crawler-john/ECU-R-RS/document/ECU_RS通讯协议0.6.docx

# ECU_RS通讯协议

文档版本号： | 0.6 | 文档编号：
文档密级： | 保密 | 归属部门/项目： | 研发部
产品名： | ECU_RS通讯协议 | 子系统名：
编写人： | | 编写日期： | 2017-05-26


昱能光伏科技集成有限公司 版权所有

内部资料 注意保密

修订记录：

修订版本号 | 修订人 | 修订日期 | 修订描述
V0.1 | 周豪军 | 2017-05-26 | 创建
V0.2 | 董笙烽 | 2017-06-05 | 固定ASK报文头部Command_Id位置为第10和第11字节，将原来的12个字节的ECU_ID移至Command_Id后面。
V0.3 | 董笙烽 | 2017-06-06 | 增加06设置IO初始状态指令
V0.4 | 董笙烽 | 2017-06-26 | 修改02系统信息请求，增加频繁重启标志。 修改06命令为关闭或者开启RSD2的rapid shut down功能
V0.5 | 董笙烽 | 2017-06-27 | 修改02系统信息请求，将频繁重启标志更改为逆变器快速关闭功能是否打开，并增加“当前一天关机次数”字段。
V0.6 | 董笙烽 | 2017-06-30 | 变更获取基本信息返回参数 变更系统信息请求返回参数

# 1 APP→ECU_RS获取基本信息的请求

Ask：

Head：

字段名 | 字节数 | 类型 | 描述
MSG_Tag | 3 | String | 消息标签，固定为字符串“APS”
MSG_Version | 2 | Number String | 1.1版本即为11，以此类推
Total_Length | 4 | Number String | 消息总长度（含消息头及消息体）。 如包的实际长度为0164个字节，用字符串“164”表示。如果不足，填充字符0
Command_Id | 2 | Number String | 获取基本信息01。
UID_MSG_End | 3 | String | 固定标志位“END”

Answer：
Head：

字段名 | 字节数 | 类型 | 描述
MSG_Tag | 3 | String | 消息标签，固定为字符串“APS”
MSG_Version | 2 | Number String | 1.1版本即为11，以此类推
Total_Length | 4 | Number String | 消息总长度（含消息头及消息体）。 如包的实际长度为0164个字节，用字符串“164”表示。如果不足，填充字符0
Command_Id | 2 | Number String | 获取UID的信息01

Body：

字段名 | 字节数 | 类型 | 描述
ECU_NO | 12 | Number String | ECU的ID号，如“101123456880”
TYPE | 3 | Number String | Ecu_Rs版本号初定为101，和逆变器区分开
SIGNAL_LEVEL | 3 | Number String | 信号强度（0-255）
SIGNAL_CHANNEL | 2 | Number String | 信号通道（0-99）
Equipment_Status | 1 | String | 当前设备连接的RSD类型 0：监控设备 1：开关设备 2：两者混搭
Length | 3 | String | 软件版本号的长度，不够补0
Version | Length | String | ECU_RS的软件版本号
UID_MSG_End | 3 | String | 固定标志位“END”

# 2 APP→ ECU_RS系统信息请求

Ask:

head

字段名 | 字节数 | 类型 | 描述
MSG_Tag | 3 | String | 消息标签，固定为字符串“APS”
MSG_Version | 2 | Number String | 1.1版本即为11，以此类推
Total_Length | 4 | Number String | 消息总长度（含消息头及消息体）。 如包的实际长度为0164个字节，用字符串“164”表示。如果不足，填充字符0
Command_Id | 2 | Number String | 系统信息请求02
Ecu_NO | 12 | Number String | ECU_RS需要检测改id是否匹配
UID_MSG_End | 3 | String | 固定标志位“END”

Answer:

head

字段名 | 字节数 | 类型 | 描述
MSG_Tag | 3 | String | 消息标签，固定为字符串“APS”
MSG_Version | 2 | Number String | 1.1版本即为11，以此类推
Total_Length | 4 | Number String | 消息总长度（含消息头及消息体）。 如包的实际长度为0164个字节，用字符串“164”表示。如果不足，填充字符0
Command_Id | 2 | Number String | 系统信息请求02
Answer | 2 | Number String | 00:ECU匹配、01:ECU不匹配（无body信息）

Body：

字段名 | 字节数 | 类型 | 描述
Valid_Num | 2 | String | 当前连接的RSD2数量 以0xD8 0xA7 俩个字节为列；可表示为DBA7的16进制数，即为56231，上限65535
Inverter_body | 设备状态适应 | String | 见下表，不同的设备存在不同的Inverter_body，通过Equipment_Status的不同，选择不同的Inverter_body。
Next_Turn | 不限 | String | 继续下次UID操作，直到结束
UID_MSG_End | 3 | String | 固定标志位“END”

Inverter_body ：

监控设备：

字段名 | 字节数 | 类型 | 描述
UID_ID | 6 | Number String | 0x40表示40，0x38表示38，只需6字节
Equipment_Status | 1 | String | 当前设备状态 0：监控设备
Status | 1 | String | 第1位：表示Mos_Status ： 1 :开、0: 关 第2位：表示rapid shut down功能是否打开：1：开、0：关 第3位：PV1欠压保护标志 1：欠压 0：非欠压 第4位：PV2欠压保护标志 1：欠压 0：非欠压
Heart_Rate | 2 | String | 以0x30 0x39 俩个字节为列；可表示为3039的16进制数，即为12345，上限65535
Off_Times | 2 | String | 以0xD8 0xA7 俩个字节为列；可表示为DBA7的16进制数，即为56231，上限65535
Shutdown_Num | 1 | String | 当前一天关机次数（系统连续一小时通讯不上表示进入晚上，清空该RSD2关机次数）
PV1_voltage | 1 | String | PV1输入电压(精度1V)
PV2_voltage | 1 | String | PV2输入电压(精度1V)
PV_electricity | 1 | String | 输入电流(精度0.1A)
PV1_power | 2 | String | PV1输入功率(精度1W)
PV2_power | 2 | String | PV2输入功率(精度1W)

开关设备：

字段名 | 字节数 | 类型 | 描述
UID_ID | 6 | Number String | 0x40表示40，0x38表示38，只需6字节
Equipment_Status | 1 | String | 当前设备状态 1：开关设备
Status | 1 | String | 第1位：表示Mos_Status ： 1 :开、0: 关 第2位：表示rapid shut down功能是否打开：1：开、0：关
Heart_Rate | 2 | String | 以0x30 0x39 俩个字节为列；可表示为3039的16进制数，即为12345，上限65535
Off_Times | 2 | String | 以0xD8 0xA7 俩个字节为列；可表示为DBA7的16进制数，即为56231，上限65535
Shutdown_Num | 1 | String | 当前一天关机次数（系统连续一小时通讯不上表示进入晚上，清空该RSD2关机次数）

# 3 APP→ECU_RS设置ECU组网

Ask:

head

字段名 | 字节数 | 类型 | 描述
MSG_Tag | 3 | String | 消息标签，固定为字符串“APS”
MSG_Version | 2 | Number String | 1.1版本即为11，以此类推
Total_Length | 4 | Number String | 消息总长度（含消息头及消息体）。 如包的实际长度为0164个字节，用字符串“164”表示。如果不足，填充字符0
Command_Id | 2 | Number String | 设置ecu组网 03
Ecu_NO | 12 | Number String | ECU_RS需要检测改id是否匹配
UID_MSG_End | 3 | String | 固定标志位“END”

Body：

字段名 | 字节数 | 类型 | 描述
UID_ID | 6 | Number String | 0x40表示40，0x38表示38，只需6字节
Next_UID | 不限 | String | 继续拼接下一个uid直到结束
UID_MSG_End | 3 | String | 固定标志位“END”

Answer:

head

字段名 | 字节数 | 类型 | 描述
MSG_Tag | 3 | String | 消息标签，固定为字符串“APS”
MSG_Version | 2 | Number String | 1.1版本即为11，以此类推
Total_Length | 4 | Number String | 消息总长度（含消息头及消息体）。 如包的实际长度为0164个字节，用字符串“164”表示。如果不足，填充字符0
Command_Id | 2 | Number String | 设置ecu组网 03
Answer | 2 | Number String | 00:下发成功、01:ECU不匹配

# 4 APP→ECU_RS设置ECU信道

Ask:

head

字段名 | 字节数 | 类型 | 描述
MSG_Tag | 3 | String | 消息标签，固定为字符串“APS”
MSG_Version | 2 | Number String | 1.1版本即为11，以此类推
Total_Length | 4 | Number String | 消息总长度（含消息头及消息体）。 如包的实际长度为0164个字节，用字符串“164”表示。如果不足，填充字符0
Command_Id | 2 | Number String | 设置ecu信道 04
Ecu_NO | 12 | Number String | ECU_RS需要检测改id是否匹配
UID_MSG_End | 3 | String | 固定标志位“END”

Body：

字段名 | 字节数 | 类型 | 描述
SIGNAL_CHANNEL | 2 | Number String | 0-99
UID_MSG_End | 3 | String | 固定标志位“END”

Answer:

head

字段名 | 字节数 | 类型 | 描述
MSG_Tag | 3 | String | 消息标签，固定为字符串“APS”
MSG_Version | 2 | Number String | 1.1版本即为11，以此类推
Total_Length | 4 | Number String | 消息总长度（含消息头及消息体）。 如包的实际长度为0164个字节，用字符串“164”表示。如果不足，填充字符0
Command_Id | 2 | Number String | 设置ecu信道 04
Answer | 2 | Number String | 00:下发成功、01:ECU不匹配（无body消息）

Body：

字段名 | 字节数 | 类型 | 描述
SIGNAL_CHANNEL | 2 | Number String | 0-99 当前通道0-99之间
SIGNAL_LEVEL | 3 | Number String | 0-255 当前信号强度0-255之间
UID_MSG_End | 3 | String | 固定标志位“END”

# 5 APP→ECU_RS设置ECUWIFI密码

Ask:

head

字段名 | 字节数 | 类型 | 描述
MSG_Tag | 3 | String | 消息标签，固定为字符串“APS”
MSG_Version | 2 | Number String | 1.1版本即为11，以此类推
Total_Length | 4 | Number String | 消息总长度（含消息头及消息体）。 如包的实际长度为0164个字节，用字符串“164”表示。如果不足，填充字符0
Command_Id | 2 | Number String | 设置ecuwifi密码 05
Ecu_NO | 12 | Number String | ECU_RS需要检测改id是否匹配
UID_MSG_End | 3 | String | 固定标志位“END”

Body：

字段名 | 字节数 | 类型 | 描述
OLD_LENGTH | 2 | Number String | 老密码长度
OLDPASSWORD | OLD_LENGTH | String | 0-99
NEW_LENGTH | 2 | Number String | 新密码长度
NEWPASSWORD | NEW_LENGTH | String | 0-99
UID_MSG_End | 3 | String | 固定标志位“END”

Answer:

head

字段名 | 字节数 | 类型 | 描述
MSG_Tag | 3 | String | 消息标签，固定为字符串“APS”
MSG_Version | 2 | Number String | 1.1版本即为11，以此类推
Total_Length | 4 | Number String | 消息总长度（含消息头及消息体）。 如包的实际长度为0164个字节，用字符串“164”表示。如果不足，填充字符0
Command_Id | 2 | Number String | 设置ecuwifi密码 05
Answer | 2 | Number String | 00:下发成功将会重启模块、01:ECU不匹配、02老密码不匹配

# 6 APP→ECU_RS关闭或者开启RSD2的rapid shut down功能

Ask:

head

字段名 | 字节数 | 类型 | 描述
MSG_Tag | 3 | String | 消息标签，固定为字符串“APS”
MSG_Version | 2 | Number String | 1.1版本即为11，以此类推
Total_Length | 4 | Number String | 消息总长度（含消息头及消息体）。 如包的实际长度为0164个字节，用字符串“164”表示。如果不足，填充字符0
Command_Id | 2 | Number String | 关闭或者开启RSD2的rapid shut down功能06
Ecu_NO | 12 | Number String | ECU_RS需要检测改id是否匹配
IO_Init_Status | 1 | String | 需要设置的优化器IO初始状态 0：低电平（关闭心跳功能）1：高电平（打开心跳功能）
UID_MSG_End | 3 | String | 固定标志位“END”

Answer:

head

字段名 | 字节数 | 类型 | 描述
MSG_Tag | 3 | String | 消息标签，固定为字符串“APS”
MSG_Version | 2 | Number String | 1.1版本即为11，以此类推
Total_Length | 4 | Number String | 消息总长度（含消息头及消息体）。 如包的实际长度为0164个字节，用字符串“164”表示。如果不足，填充字符0
Command_Id | 2 | Number String | 关闭或者开启RSD2的rapid shut down功能06
Answer | 2 | Number String | 00: 下发成功、01:ECU不匹配
