crawler-john/ECU-R-RS/document/ECU-RS-BOM-REV1.0-20170621.XLS

物料清单资料查询
母件编码 19608710000 |  |  |  |  |  | 母件名称 ECU-RS-REV1.0 PCBA |  |  |  |  |  | 规格型号
版本说明 REV1.0 |  |  |  |  |  | Article No.
描述
备注 2017-6-21 新建
级次 | 子件编码 | 变更标示 | 子件名称 | 子件规格 | 描述 | 主计量单位名称 | 基本用量 | 位置号1 | 位置号2 | 制造商 | 工段 | 替代标识 | 是否前烧录 | 是否特殊物料 | 替代标志 | 备注 | 单位参考成本
+1 | 12110000000 |  | 四角按键 | KFC＿A36＿08A | SMD | Pcs | 1.0000 | BP2 |  | 泰安达电子 | SMT
+1 | 10011052100 |  | 陶瓷电容 | CC0603KRX5R6BB105 | 1uF∕10V∕10%∕0603 | Pcs | 3.0000 | C1/C19/C20 |  | YAGEO | SMT
+1 | 10091042100 |  | 陶瓷电容 | CC0603KRX7R7BB104 | 100nF/16V/10%/0603 | Pcs | 11.0000 | C2/C3/C4/C5/C6/C10/C11/C18/C236/C277/C279 |  | YAGEO | SMT
+1 | 10031011100 |  | 陶瓷电容 | CC0603JRNPO9BN101 | 100pF/50V/5%/0603 | Pcs | 1.0000 | C7 |  | YAGEO | SMT
+1 | 10092252200 |  | 陶瓷电容 | CC0805KKX7R7BB225 | 2.2uF/16V/10%/0805 | Pcs | 2.0000 | C8/C9 |  | YAGEO | SMT
+1 | 10031001100 |  | 陶瓷电容 | CC0603JRNPO9BN100 | 10pF/50V/5%/0603 | Pcs | 2.0000 | C16/C17 |  | YAGEO | SMT
+1 | 10004752100 |  | 陶瓷电容 | CC0603KRX5R5BB475 | 4.7uF/6.3V/10%/0603 | Pcs | 1.0000 | C21 |  | YAGEO | SMT
+1 | 10034752300 |  | 陶瓷电容 | CC1206KKX7R9BB475 | 4.7uF/50V/10%/1206 | Pcs | 1.0000 | C48 |  | YAGEO | SMT
+1 | 10031032100 |  | 陶瓷电容 | CC0603KRX7R9BB103 | 10nF/50V/10%/0603 | Pcs | 1.0000 | C53 |  | YAGEO | SMT
+1 | 14301833710 |  | 发光二极管 | EC04-0805GC/E-AV | EC04(0805)绿 | Pcs | 2.0000 | D21/D22 |  | EVER BRIGHT | SMT
+1 | 12060000000 |  | 单排插针 | 1*2.54mm间距 引脚长度11mm 40pin | DIP | Pcs | 3.0000 | JP6/JP7/J4 |  | 国产 | DIP
+1 | 12180000001 |  | IPEX接口 |  |  | Pcs | 1.0000 | J1 |  | 昭华电子 | SMT
+1 | 12080002102 |  | 电源插座 | DC-0005D |  | Pcs | 1.0000 | J2 |  | 苏州昭华电子有限公司 | DIP
+1 | 12132021005 |  | wifi模块 | USR-WIFI232-B2 |  | Pcs | 1.0000 | J13 |  | 有人 | DIP
+1 | 17120025114 |  | 看门狗芯片 | MCP1316MT-29LE/OT | SOT-23-5 | Pcs | 1.0000 | MN3 |  | Microchip | SMT
+1 | 14700040007 |  | NPN型三极管 | MMBT2222A | SOT-23 | Pcs | 1.0000 | Q3 |  | Fairchild | SMT
+1 | 11001031100 |  | 贴片电阻 | RC0603JR-0710KL | 10K,5%,0603 | Pcs | 8.0000 | R1/R2/R3/R4/R5/R13/R14/R15 |  | YAGEO | SMT
+1 | 11082520100 |  | 贴片电阻 | RC0603FR-0782K5L | 82.5K,1﹪,0603 | Pcs | 1.0000 | R7 |  | YAGEO | SMT
+1 | 11004731100 |  | 贴片电阻 | RC0603JR-0747KL | 47K,5%,0603 | Pcs | 1.0000 | R8 |  | YAGEO | SMT
+1 | 11001020100 |  | 贴片电阻 | RC0603FR-071KL | 1K,1%,0603 | Pcs | 3.0000 | R9/R23/R199 |  | YAGEO | SMT
+1 | 11001011200 |  | 贴片电阻 | RC0805JR-07100RL | 100R，5﹪，0805 | Pcs | 1.0000 | R27 |  | YAGEO | SMT
+1 | 11005120100 |  | 贴片电阻 | RC0603FR-075K1L | 5.1K,1%,0603 | Pcs | 1.0000 | R35 |  | YAGEO | SMT
+1 | 11001010100 |  | 贴片电阻 | RC0603FR-07100RL | 100R，1﹪，0603 | Pcs | 1.0000 | R36 |  | YAGEO | SMT
+1 | 11001520100 |  | 贴片电阻 | RC0603FR-071K5L | 1.5K,1%,0603 | Pcs | 2.0000 | R164/R165 |  | YAGEO | SMT
+1 | 11001030100 |  | 贴片电阻 | RC0603FR-0710KL | 10K,1%,0603 | Pcs | 1.0000 | R342 |  | YAGEO | SMT
+1 | 11004720100 |  | 贴片电阻 | RC0603FR-074K7L | 4.7K,1﹪,0603 | Pcs | 1.0000 | R351 |  | YAGEO | SMT
+1 | 11000000100 |  | 贴片电阻 | RC0603FR-070RL | 0R，1﹪，0603 | Pcs | 2.0000 | R282/R352 |  | YAGEO | SMT
+1 | 17061096237 |  | 单片机MCU芯片 | GD32F101C8T6 | LQFP48 | Pcs | 1.0000 | U1 |  | Gigadevice | SMT
+1 | 17040186141 |  | 电源芯片 | SGM2028ADJYN5G/TR | SOT-23-5 | Pcs | 1.0000 | U2 |  | SGMICRO | SMT
+1 | 12133011104 |  | 射频模块 | RFM300H-433S2 | 工作频段433MHz | Pcs | 1.0000 | U3 |  | HOPERF | SMT
+1 | 17010022114 |  | flash 芯片 | 24LC64T-I/SN | SOIC8 | Pcs | 1.0000 | U12 |  | Microchip | SMT
+1 | 19111110104 |  | 8MHz无源晶振 | XJHCCLNANF-8.000000MHz | 8MHz_±20PPM_SMD_无源晶振_昆山正耀 | Pcs | 1.0000 | Y1 |  | TAITIEN | SMT
+1 | 19508710008 |  | PCB | ECU-RS-REV1.0 |  | Pcs | 1.0000 | PCB |  | 依利安达 | SMT
合计
制单人 蔡宁 |  |  |  |  |  | 制单日期 2017-06-21 |  |  |  |  |  | 修改日期
