crawler-john/ECU-R-RS/document/ECU-RS-SCH-V1_0-20170522B.xlsx

RSD2 Revised: Monday, May 22, 2017
Revision: 1.0
Bill Of Materials June 12,2017 15:06:37 | Page1
Item | Quantity | Reference | Part | Footprint
______________________________________________
1 | 1 | BP2 | KFC_A36_08A | SW4-KFC-A36-08 | 12110000000 | 四角按键
2 | 3 | C1,C19,C20 | 1uF∕10V∕10%∕0603 | C0603 | 10011052100 | 陶瓷电容
3 | 10 | C2,C3,C4,C5,C6,C10,C11,C18,C236,C277,C279 | 100nF/16V/10%/0603 | C0603 | 10091042100 | 陶瓷电容
4 | 1 | C7 | 100pF/50V/5%/0603 | C0603 | 10031011100 | 陶瓷电容
5 | 2 | C8,C9 | 2.2uF/16V/10%/0805 | C0805 | 10092252200 | 陶瓷电容
6 | 4 | C16,C17 | 10pF/50V/5%/0603 | C0603 | 10031001100 | 陶瓷电容
7 | 1 | C21 | 4.7uF/6.3V/10%/0603 | C0603 | 10004752100 | 陶瓷电容
8 | 1 | C48 | 4.7uF/50V/10%/1206 | C1206 | 10034752300 | 陶瓷电容
9 | 1 | C53 | 10nF/50V/10%/0603 | C0603 | 10031032100 | 陶瓷电容
11 | 2 | D21,D22 | Led Green HSMG-C170 | LED_0805 | 14301833710 | 发光二极管
12 | 2 | JP6,JP7 | TSW 2PTS-DROIT_1 | SIP2_254 | 2孔 | 排针 | 1*2.54mm间距 引脚长度11mm 40pin
13 | 1 | J1 | Ipex | IPEX-3pin |  | 天线插座
14 | 1 | J2 | DC-0005D | SW-3PIN | 12080002102 | 直流插座
16 | 1 | J4 | CON2 | HD1X2_254 | 2孔 | 排针+短路帽 | 1*2.54mm间距 引脚长度11mm 40pin
18 | 1 | J13 | WIFI conned | HD2x7_2_0-WIFI |  | 有人WIFI模块
19 | 1 | MN3 | MCP1316MT-29LE/OT DNP | SOT23_5-095-280N |  | MCP1316MT-29LE/OT
21 | 1 | Q3 | 2N1069 | sot-23 |  | 三极管
22 | 8 | R1,R2,R3,R4,R5,R13,R14,R15 | 10K,5%,0603 | R0603 | 11001031100 | 贴片电阻
23 | 1 | R7 | 82.5K,1﹪,0603 | R0603 | 11082520100 | 贴片电阻
24 | 1 | R8 | 47.5K | R0603
25 | 3 | R9,R23,R199 | 1K,1%,0603 | R0603 | 11001020100 | 贴片电阻
26 | 1 | R27 | 100R，5﹪，0805 | R0805 | 11001011200 | 贴片电阻
27 | 1 | R35 | 5.1K,1%,0603 | R0603 | 11005120100 | 贴片电阻
28 | 1 | R36 | 100R，1﹪，0603 | R0603 | 11001010100 | 贴片电阻
29 | 2 | R164,R165 | 1.5K,1%,0603 | R0603 | 11001520100 | 贴片电阻
31 | 1 | R342 | 10K,1%,0603 | R0603 | 11001030100 | 贴片电阻
32 | 1 | R351 | 4.7K,1﹪,0603 | R0603 | 11004720100 | 贴片电阻
33 | 1 | R282,R352 | 0R，1﹪，0603 | R0603 | 11000000100 | 贴片电阻
35 | 1 | U1 | GD32F101C8T6 | QFP48_050-900X900 |  | GD32F101C8T6芯片
36 | 1 | U2 | SGM2028ADJYN5G/TR | sot-23-5 |  | 电源芯片
37 | 1 | U3 | RFM300H | RFM300H |  | 433模块
38 | 1 | U12 | 24LC64 | SOP8_127-620X500 | 17010022114 | flash 芯片
39 | 1 | Y1 | 8M | CRYS2_1140X480 | 19111110104 | 8MHz无源晶振
