crawler-john/ECU-R-RS/document/ECU-RS-SCH-V1_0-20170522B.pdf

### WIFI_TX

### WIFI_RST

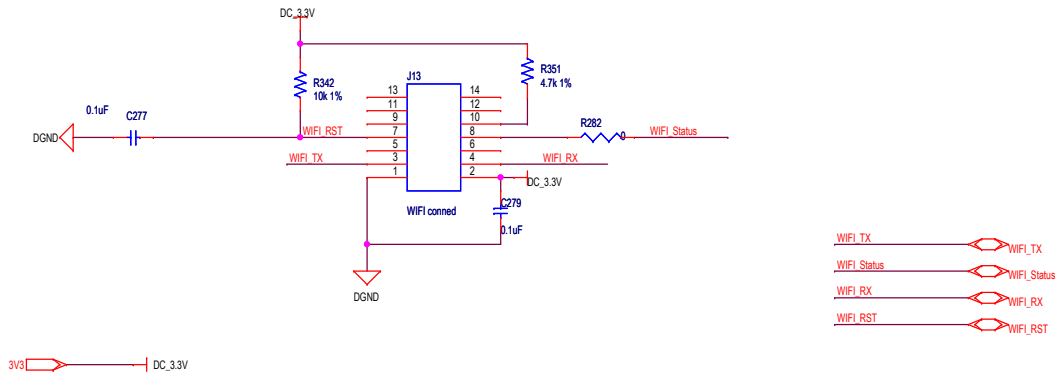
[picture p2: page 1]
WIFI_RX; WIFI_Status; WIFI_TX; WIFI_RST; DGND; WIFI conned

### EEPROM_SDA

### EEPROM_SCL

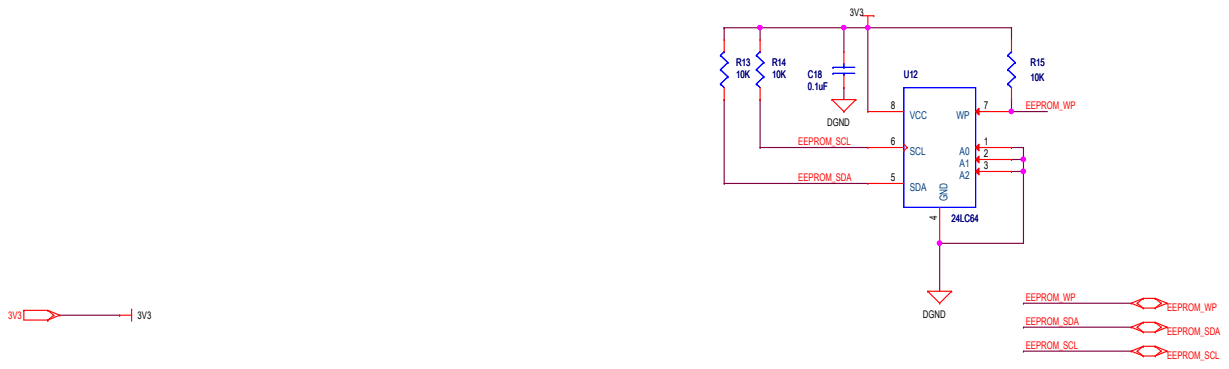
[picture p3: page 2]
EEPROM_WP; EEPROM_SDA; EEPROM_SCL; DGND; GND; SDA; SCL; VCC

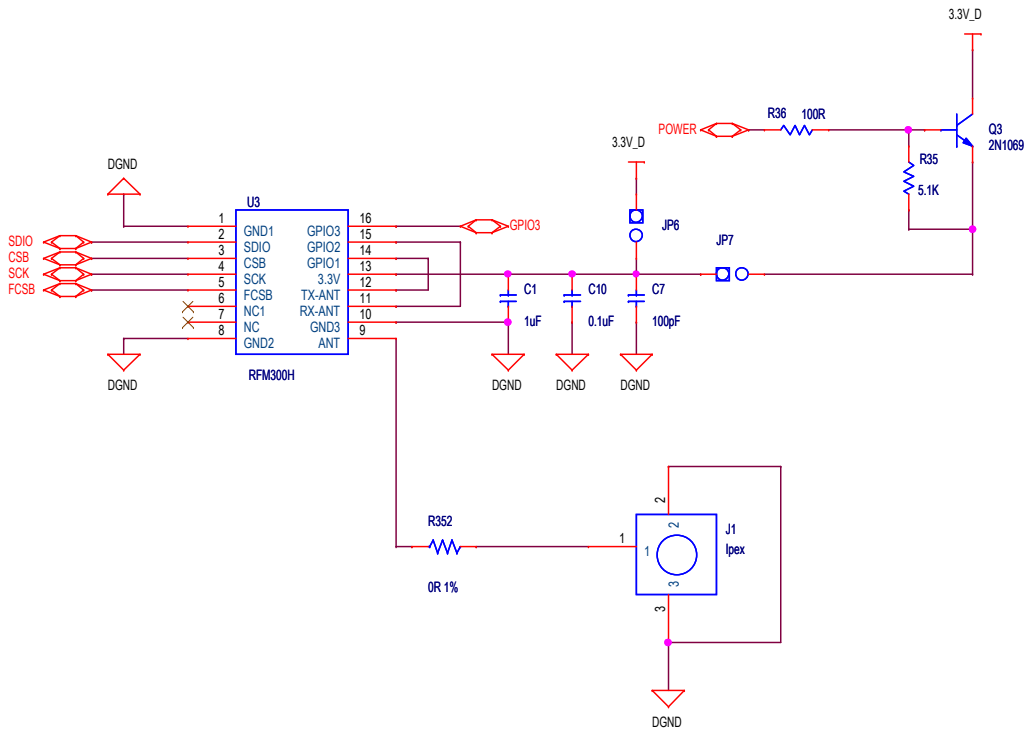
[picture p4: page 3]

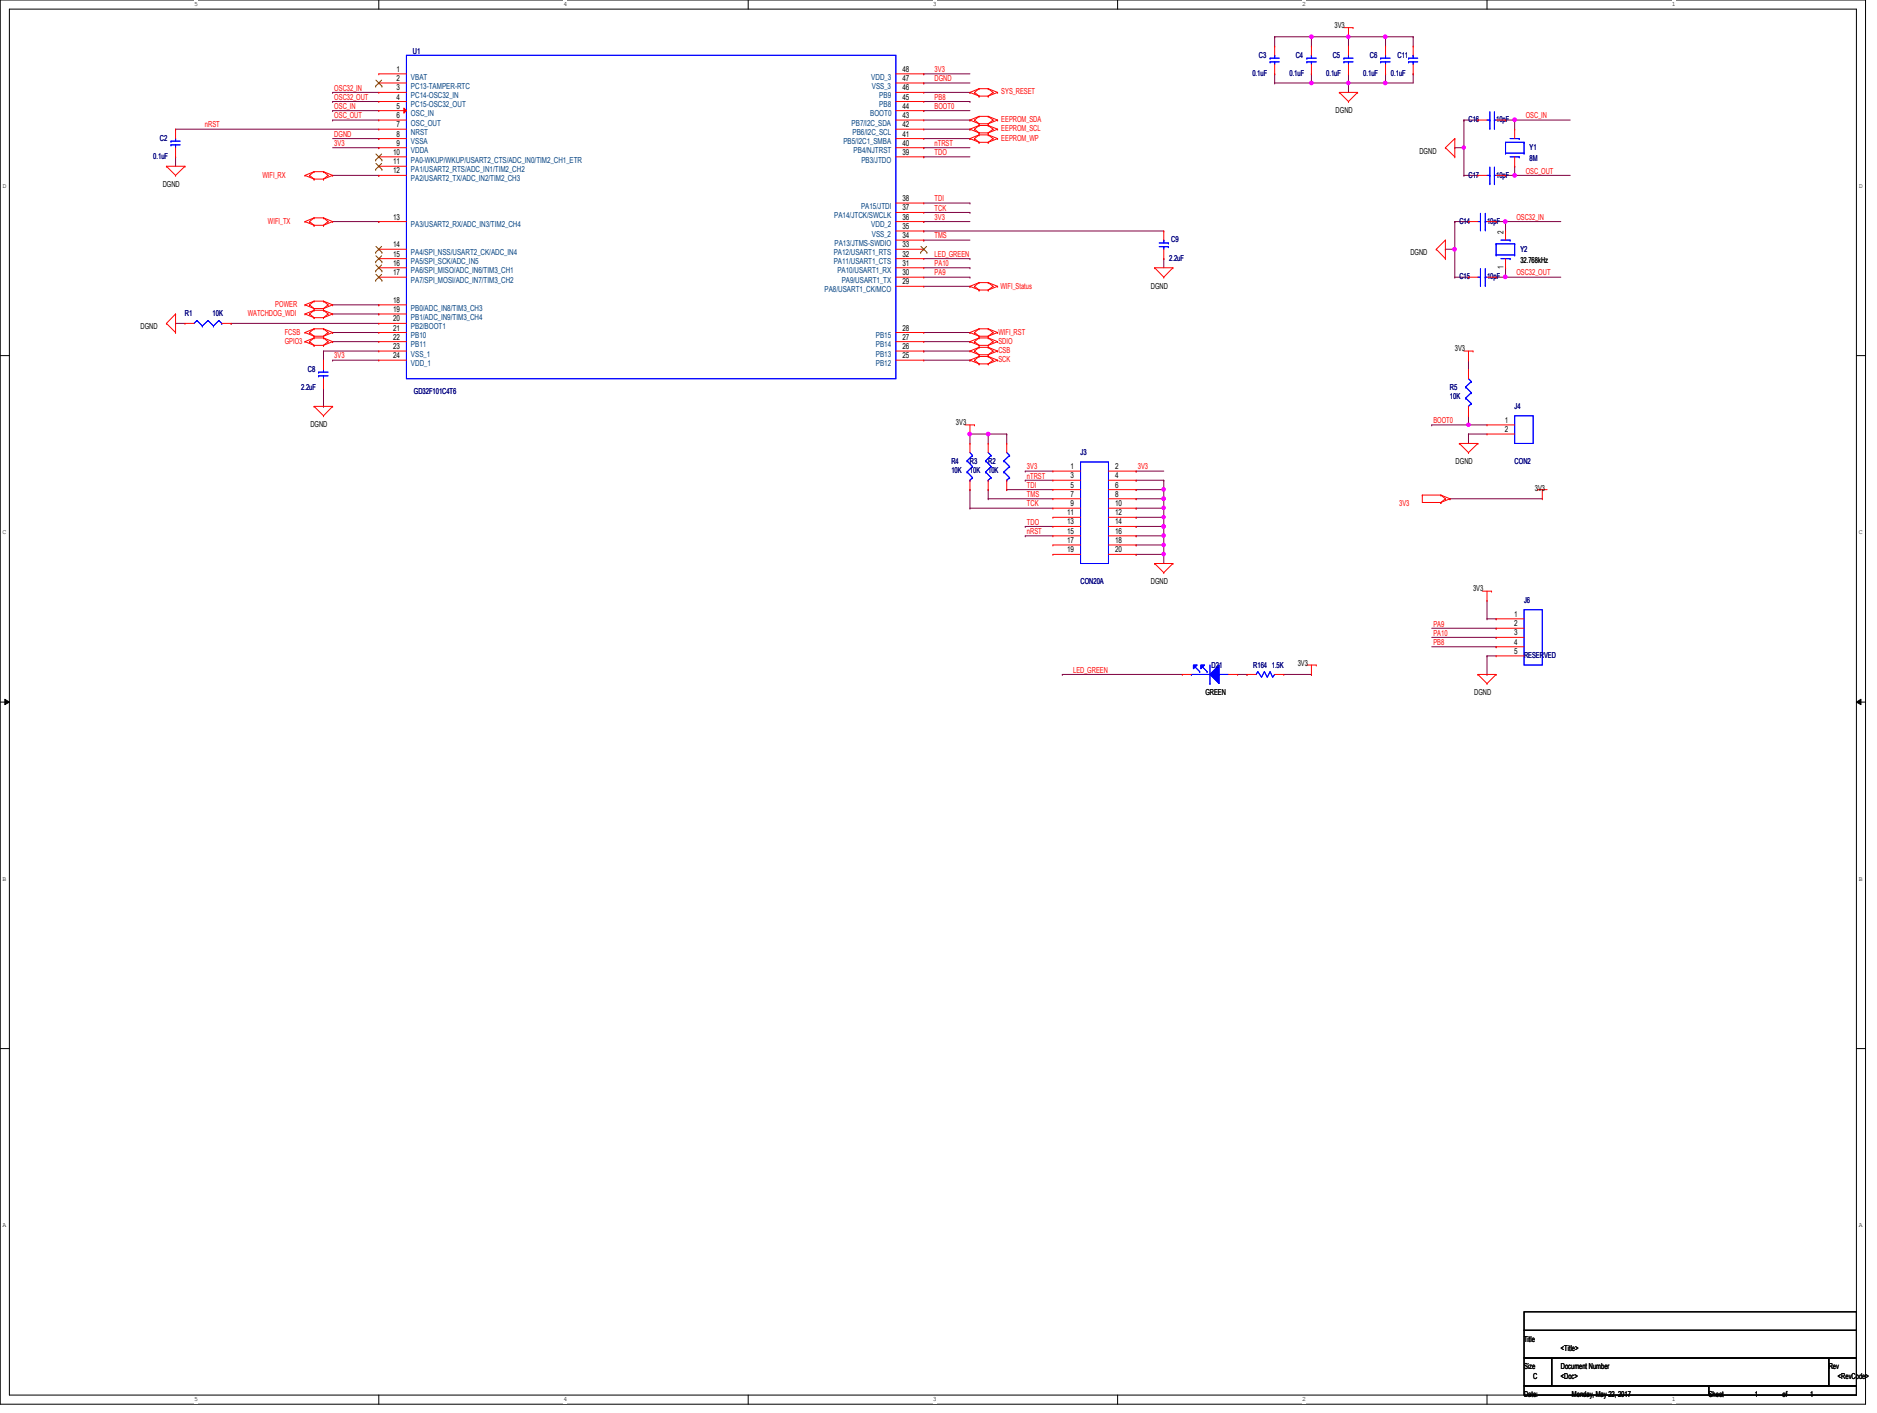
[picture p5: page 4]

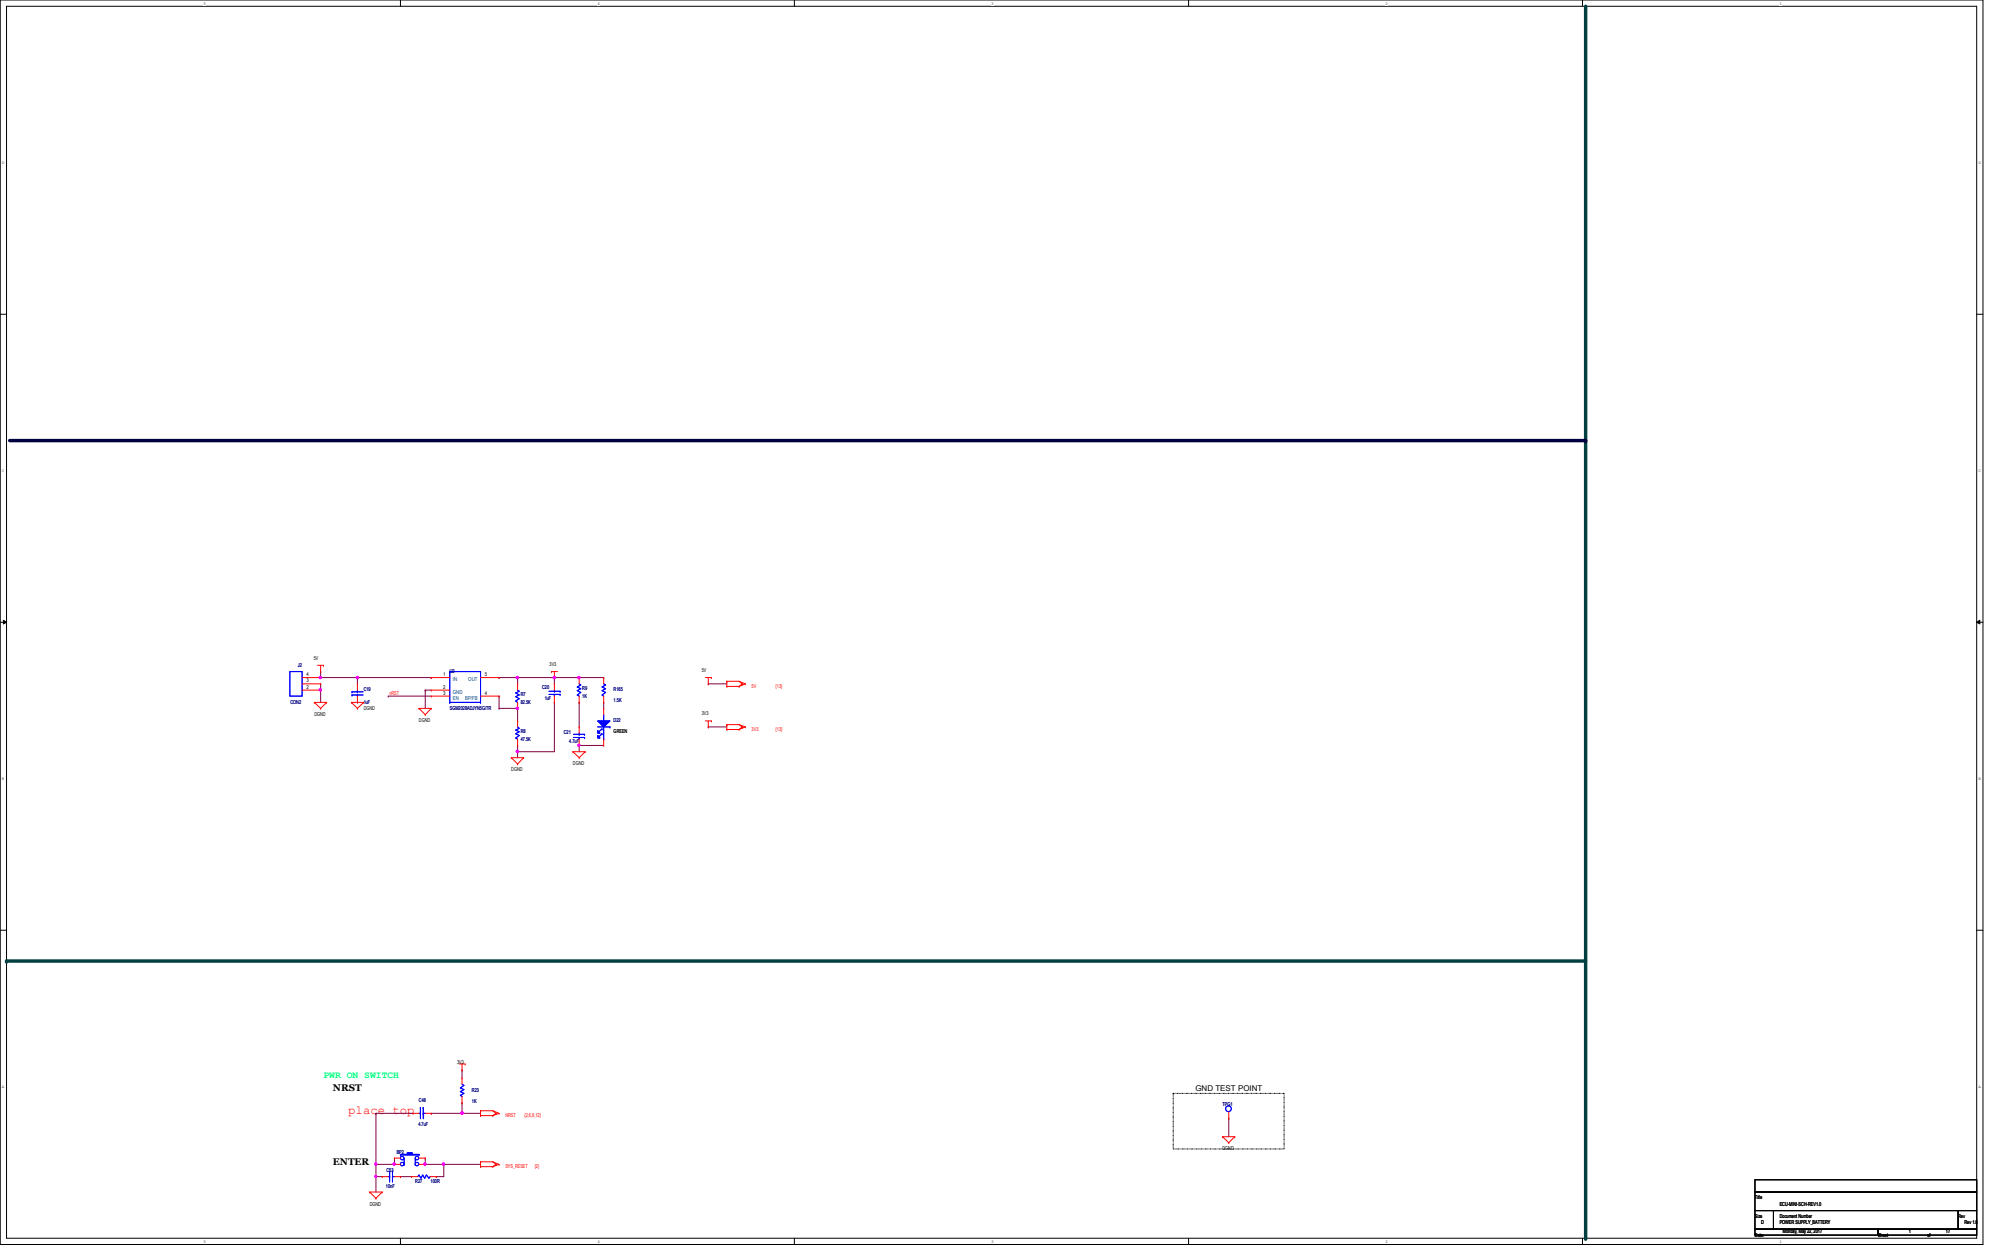
[picture p6: page 5]

# LOG FILE

# REV 1.0 First version of RSD2(2017.05.10)

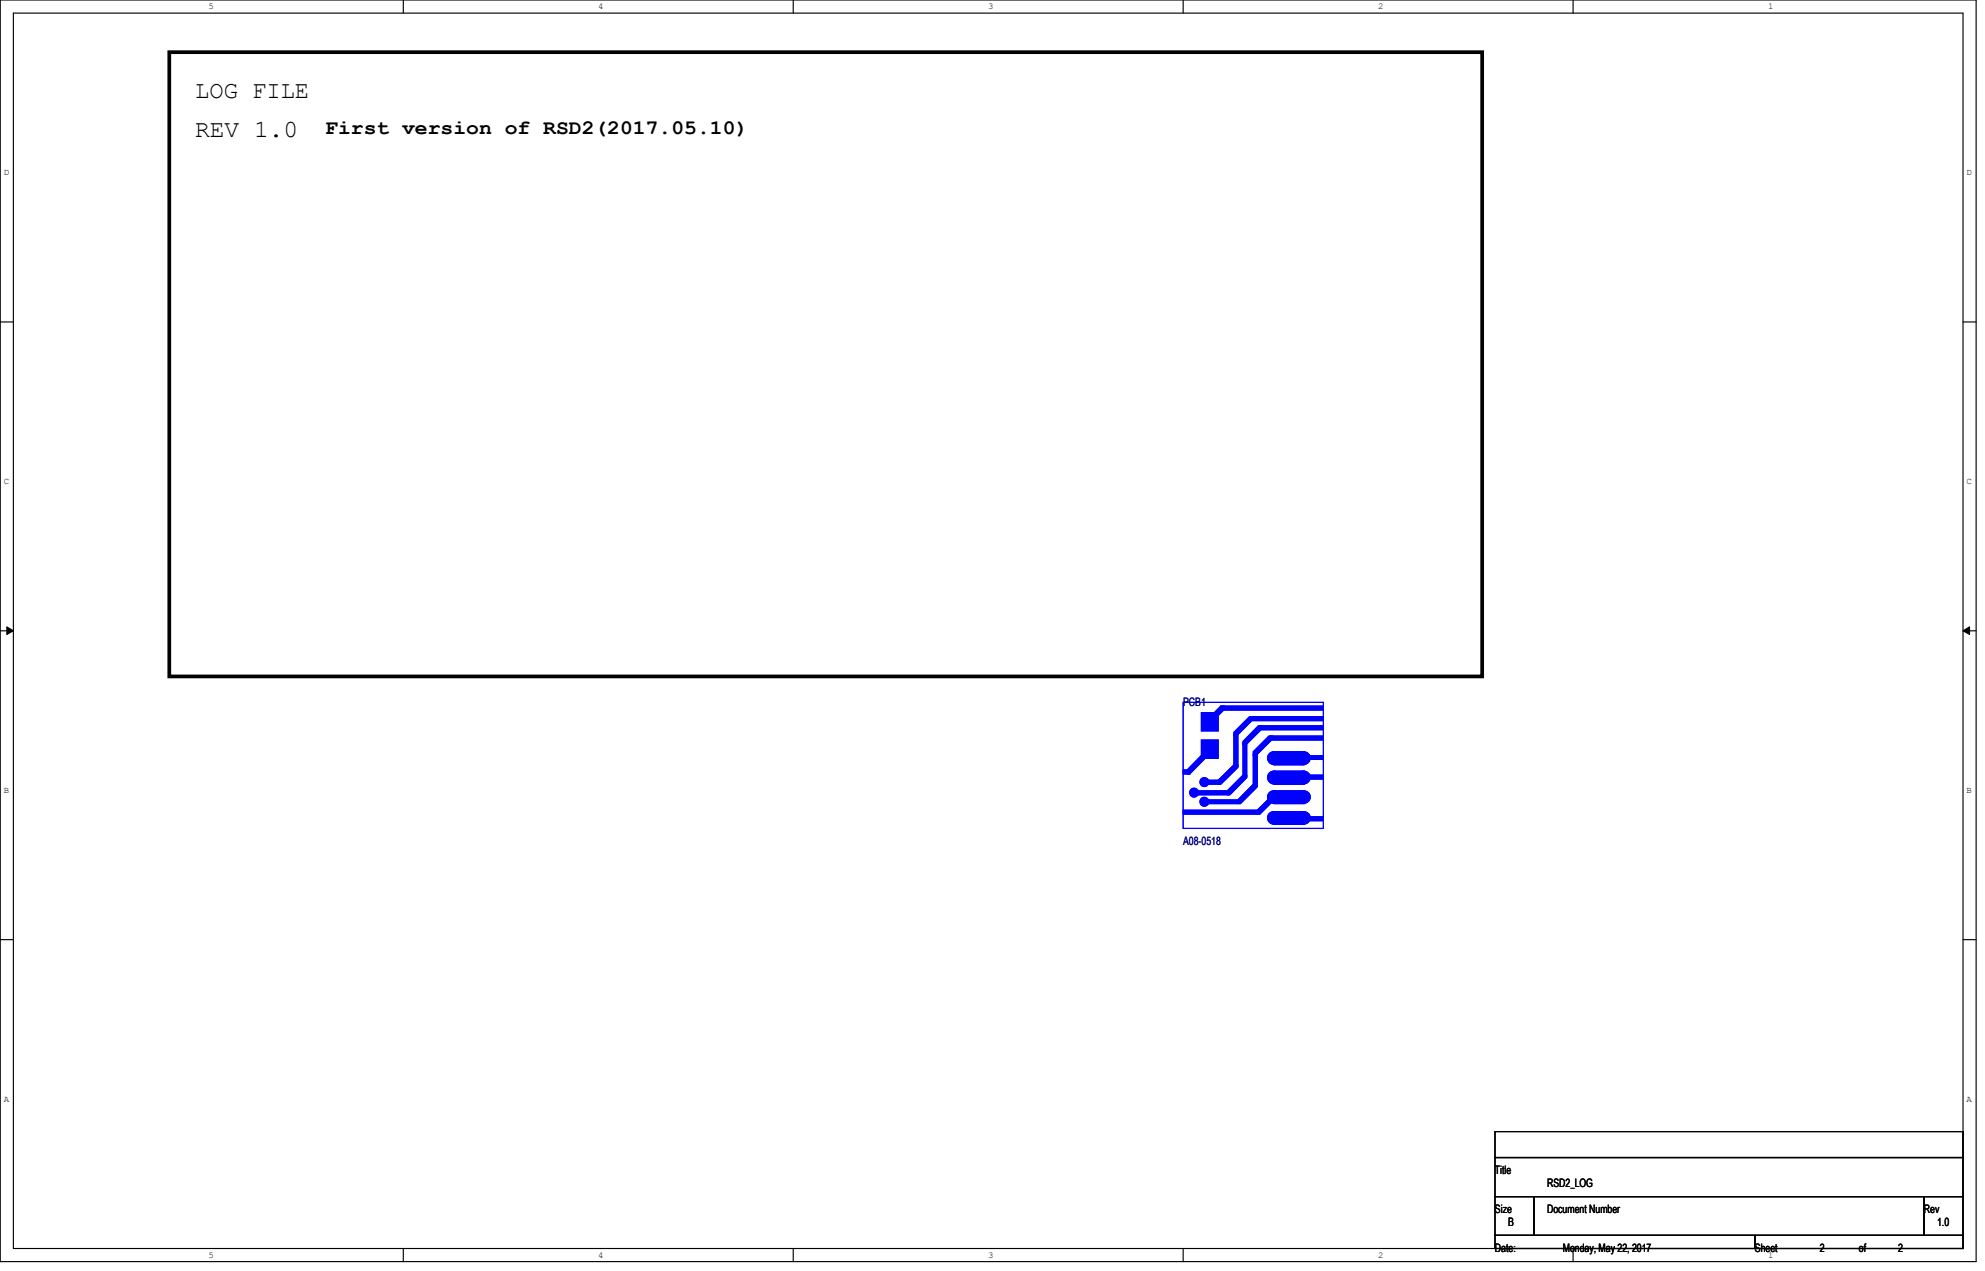
[picture p7: page 6]
Title; Size; Document Number; Rev; Date:; Sheet; RSD2_LOG; Monday, May 22, 2017; PCB1

D D

3V3

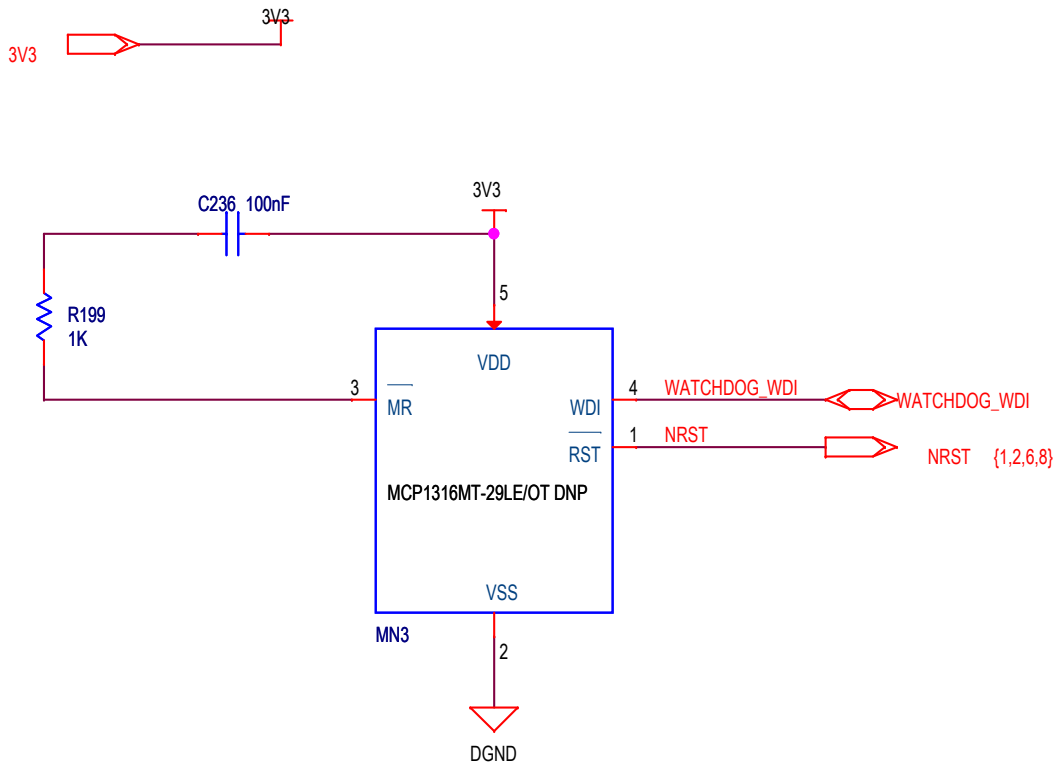
[picture p8: page 7]
WATCHDOG_WDI; NRST; DGND; NRST {1,2,6,8}; Title; WATCHDOG; Rev 1.0; Monday, May 22, 2017; MCP1316MT-29LE/OT DNP; RST; VDD; WDI; VSS

ECU-MINI-SCH-REV1.0
