crawler-john/ECU-R-RS/drivers/LED/led.c

/*****************************************************************************/
/* File      : led.c                                                         */
/*****************************************************************************/
/*  History:                                                                 */
/*****************************************************************************/
/*  Date       * Author          * Changes                                   */
/*****************************************************************************/
/*  2017-05-27 * Shengfeng Dong  * Creation of the file                      */
/*             *                 *                                           */
/*****************************************************************************/

/*****************************************************************************/
/*  Include Files                                                            */
/*****************************************************************************/
#include <stm32f10x.h>

#define led1_rcc                    RCC_APB2Periph_GPIOA
#define led1_gpio                   GPIOA
#define led1_pin                    (GPIO_Pin_11)

void LED_init(void)
{
    GPIO_InitTypeDef GPIO_InitStructure;

    RCC_APB2PeriphClockCmd(led1_rcc,ENABLE);

    GPIO_InitStructure.GPIO_Mode  = GPIO_Mode_Out_PP;
    GPIO_InitStructure.GPIO_Speed = GPIO_Speed_50MHz;

    GPIO_InitStructure.GPIO_Pin   = led1_pin;
    GPIO_Init(led1_gpio, &GPIO_InitStructure);
		GPIO_SetBits(led1_gpio, led1_pin);
}

void LED_on(void)
{
    GPIO_ResetBits(led1_gpio, led1_pin);
}

void LED_off(void)
{
    GPIO_SetBits(led1_gpio, led1_pin);
}
