crawler-john/ECU-R-RS/drivers/LED/led.h

/*****************************************************************************/
/* File      : led.h                                                         */
/*****************************************************************************/
/*  History:                                                                 */
/*****************************************************************************/
/*  Date       * Author          * Changes                                   */
/*****************************************************************************/
/*  2017-05-27 * Shengfeng Dong  * Creation of the file                      */
/*             *                 *                                           */
/*****************************************************************************/
#ifndef __LED_H__
#define __LED_H__

/*****************************************************************************/
/*  Function Declarations                                                    */
/*****************************************************************************/
void LED_init(void);	//LED初始化
void LED_on(void);		//LED亮
void LED_off(void);		//LED熄灭

#endif
