crawler-john/ECU-R-RS/(commit log)

2017-08-07 1.第一次上传 2.版本1.2
    [ECU-RS-BOM-REV1.0-20170621.XLS, ECU-RS-SCH-V1_0-20170522B.xlsx, ECU-RS存储地址分配.xlsx]
2017-08-07 1.1.3版本
    [ECU-RS-BOM-REV1.0-20170621.XLS, 温升.xlsx]
