crawler-john/ECU-R-RS/(notices)

Notices in the files:
drivers/SYSTEM/sys/sys.h:
Copyright(C) ¹ãÖÝÊÐÐÇÒíµç×Ó¿Æ¼¼ÓÐÏÞ¹«Ë¾ 2009-2019
All rights reserved
